mlab-modules/PCRD01/README.md

# PCRD01B
Semiconcductor cosmic radiation detector Silicon diode analogue amplifier. 

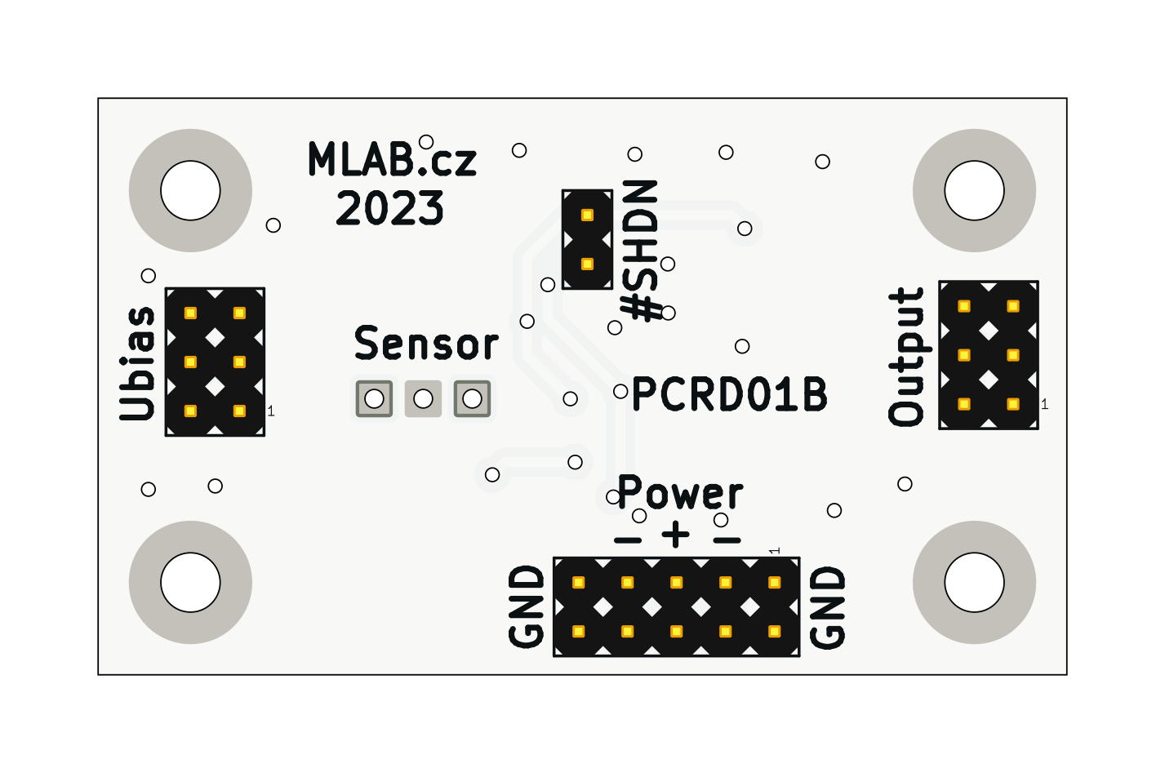
[picture p1: doc/gen/img/PCRD01-top.png]
PCRD01A
