mlab-modules/PCRD01/doc/gen/img/PCRD01-bottom.png

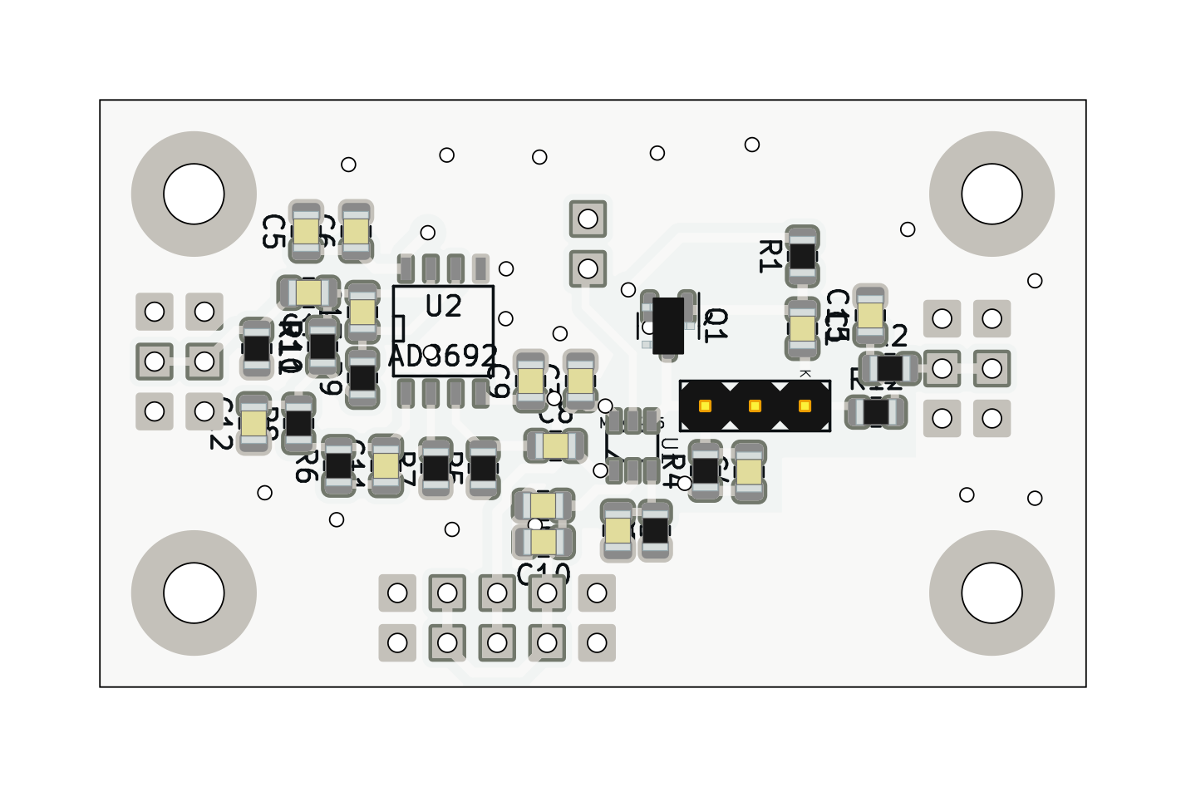
doc/gen/img/PCRD01-bottom.png
