mlab-modules/PCRD01/doc/gen/dxf/PCRD01-F_Cu.dxf

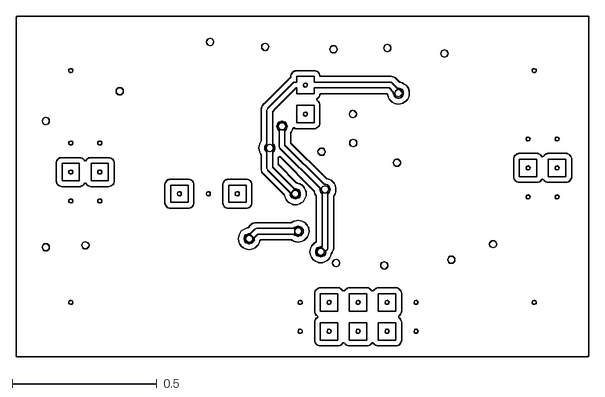
[picture p7: CAD file, 2023-07-05]
doc/gen/dxf/PCRD01-F_Cu.dxf
1.98 x 1.18
