mlab-modules/PCRD01/doc/gen/PCRD01.step

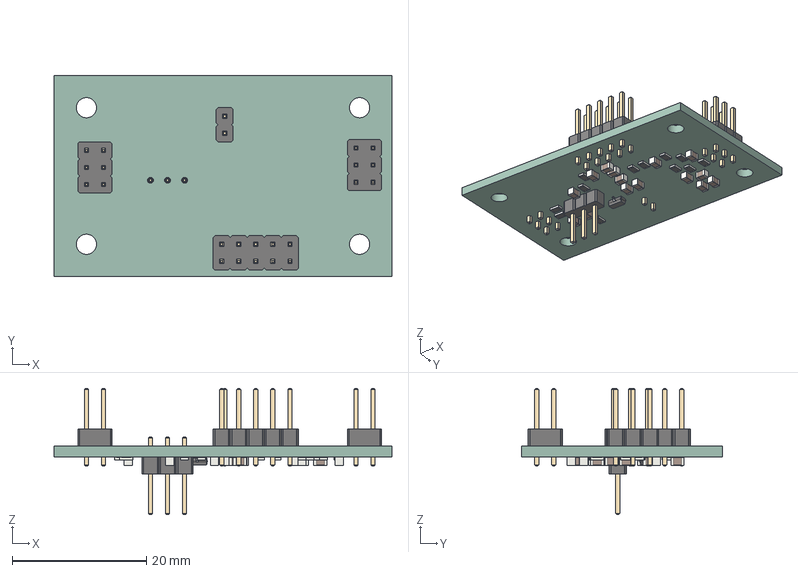
[picture p8: CAD file, 2023-07-05]
doc/gen/PCRD01.step
50.3 x 30.0 x 18.8 mm
tmp4__d5pkj PCB
