mlab-modules/PCRD01/doc/gen/dxf/PCRD01-User_Comments.dxf

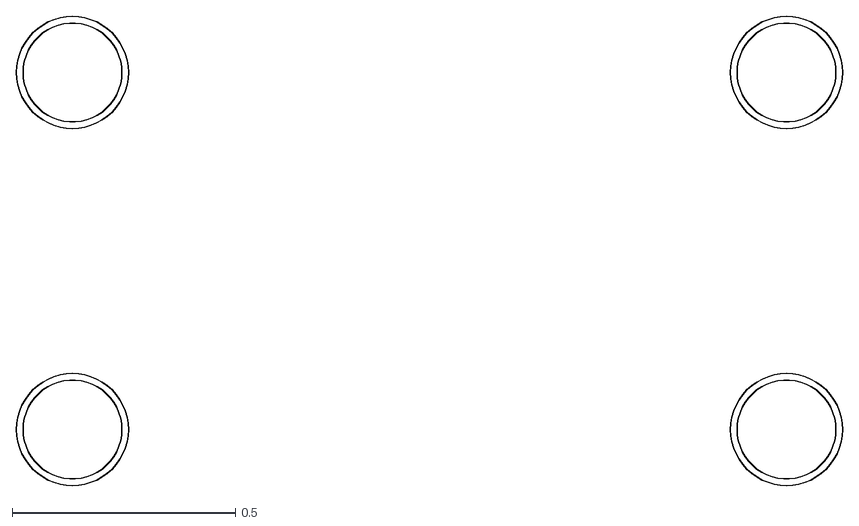
[picture p9: CAD file, 2023-07-05]
doc/gen/dxf/PCRD01-User_Comments.dxf
1.85 x 1.05
