mlab-modules/PCRD01/doc/gen/dxf/PCRD01-Edge_Cuts.dxf

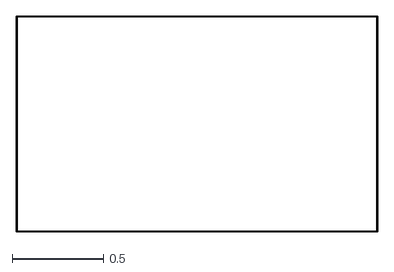
[picture p10: CAD file, 2023-07-05]
doc/gen/dxf/PCRD01-Edge_Cuts.dxf
1.98 x 1.18
