mlab-modules/PCRD01/doc/gen/dxf/PCRD01-B_Fab.dxf

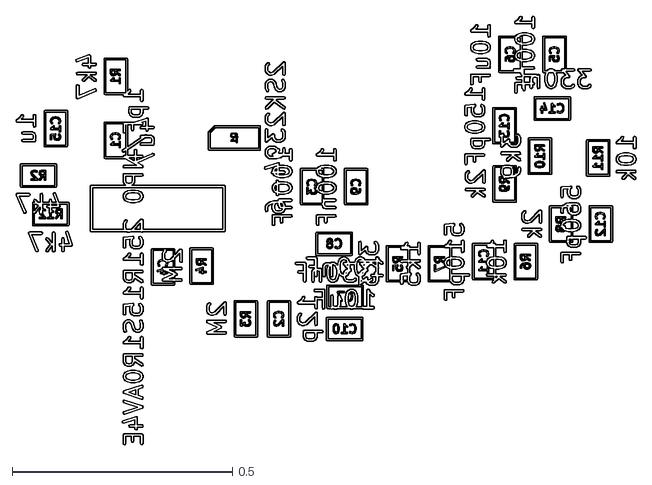
[picture p11: CAD file, 2023-07-05]
doc/gen/dxf/PCRD01-B_Fab.dxf
1.41 x 0.972
