mlab-modules/PCRD01/doc/gen/dxf/PCRD01-B_Cu.dxf

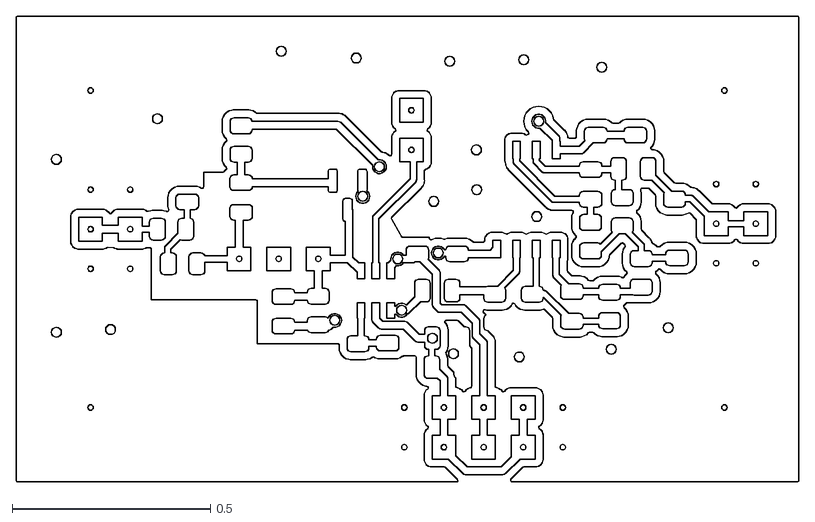
[picture p12: CAD file, 2023-07-05]
doc/gen/dxf/PCRD01-B_Cu.dxf
1.98 x 1.18
