mlab-modules/PCRD01/doc/gen/dxf/PCRD01-B_Courtyard.dxf

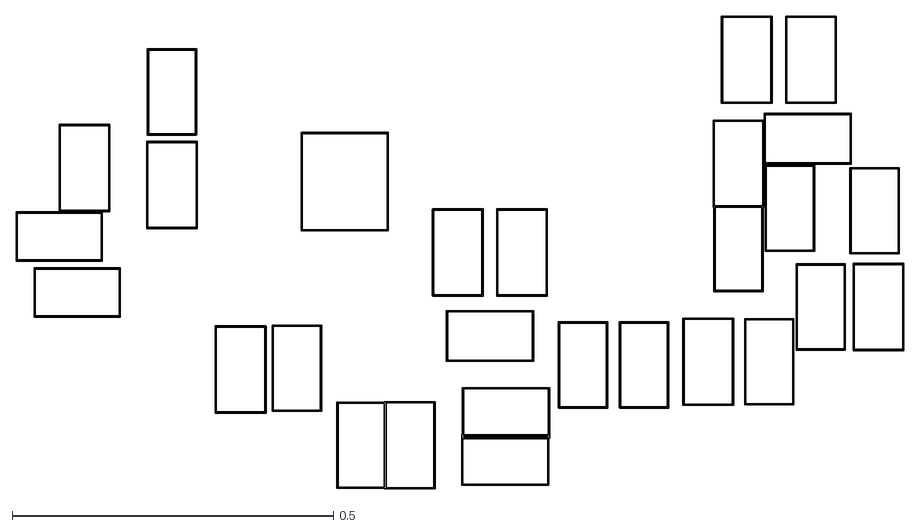
[picture p13: CAD file, 2023-07-05]
doc/gen/dxf/PCRD01-B_Courtyard.dxf
1.38 x 0.736
