mlab-modules/PCRD01/doc/gen/dxf/PCRD01-F_Fab.dxf

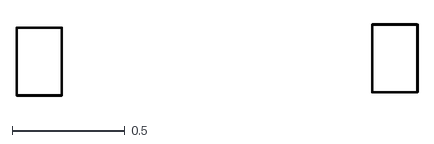
[picture p14: CAD file, 2023-07-05]
doc/gen/dxf/PCRD01-F_Fab.dxf
1.78 x 0.32
