mlab-modules/PCRD01/doc/gen/dxf/PCRD01-F_Adhesive.dxf

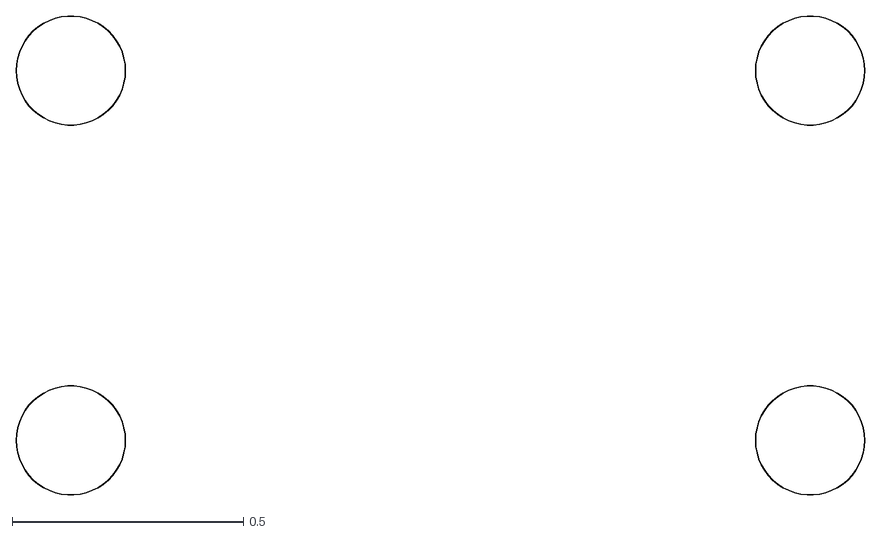
[picture p15: CAD file, 2023-07-05]
doc/gen/dxf/PCRD01-F_Adhesive.dxf
1.84 x 1.04
