mlab-modules/PCRD01/(list of files, cad)

Other CAD files:
doc/gen/dxf/PCRD01-User_Eco2.dxf
doc/gen/dxf/PCRD01-User_Drawings.dxf
doc/gen/dxf/PCRD01-F_Courtyard.dxf
doc/gen/dxf/PCRD01-Margin.dxf
doc/gen/dxf/PCRD01-User_Eco1.dxf
doc/gen/dxf/PCRD01-B_Mask.dxf
doc/gen/dxf/PCRD01-B_Paste.dxf
doc/gen/dxf/PCRD01-B_Silkscreen.dxf
doc/gen/dxf/PCRD01-F_Mask.dxf
doc/gen/dxf/PCRD01-F_Paste.dxf
doc/gen/dxf/PCRD01-F_Silkscreen.dxf
