mlab-modules/PCRD01/doc/gen/PCRD01-schematic.pdf

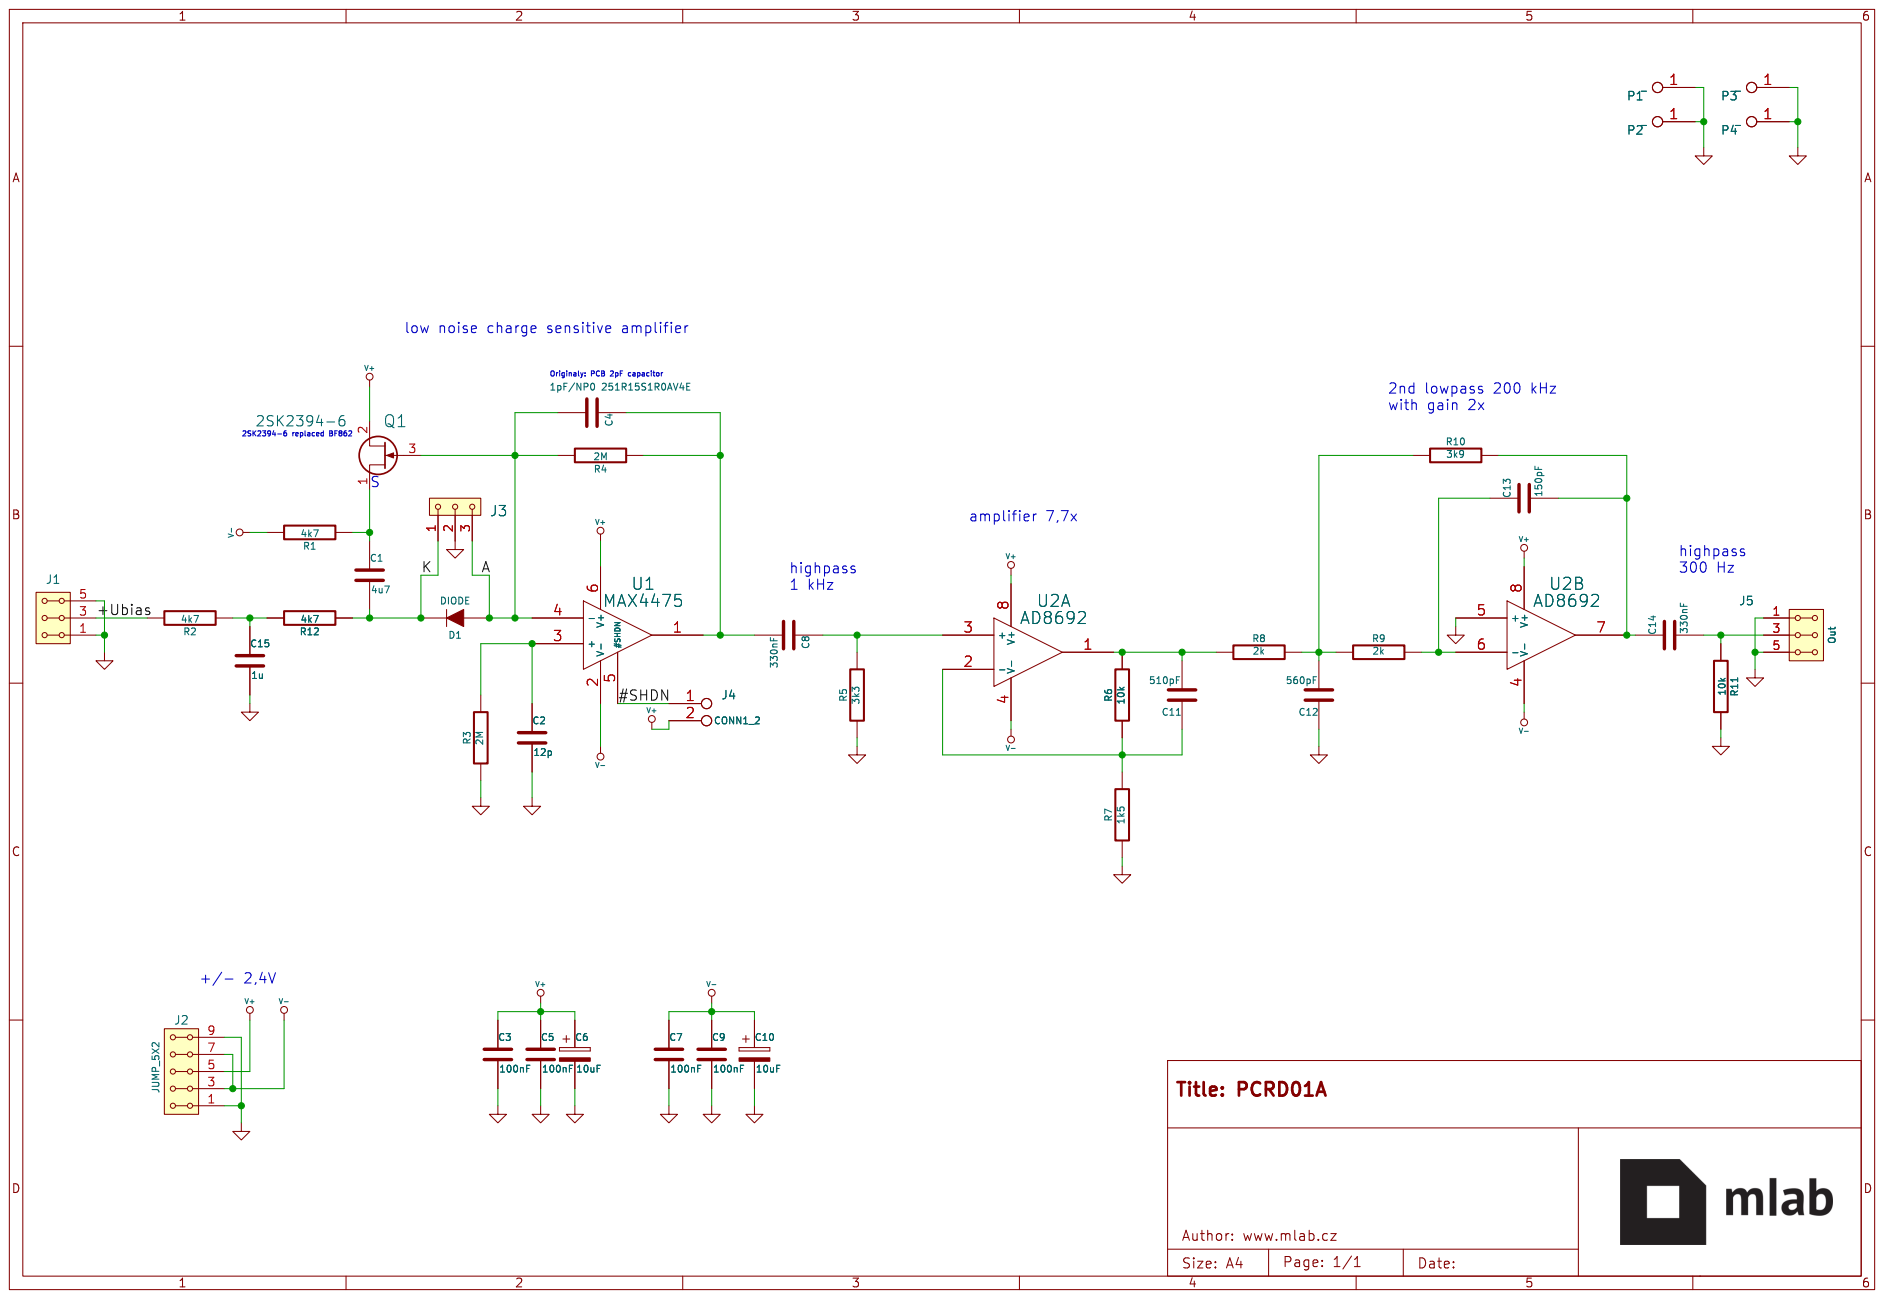
[picture p16: page 1]

low noise charge sensitive amplifier
