mlab-modules/PCRD01/hw/cam_profi/docs/PCRD01B-B_Fab+Edge_Cuts.pdf

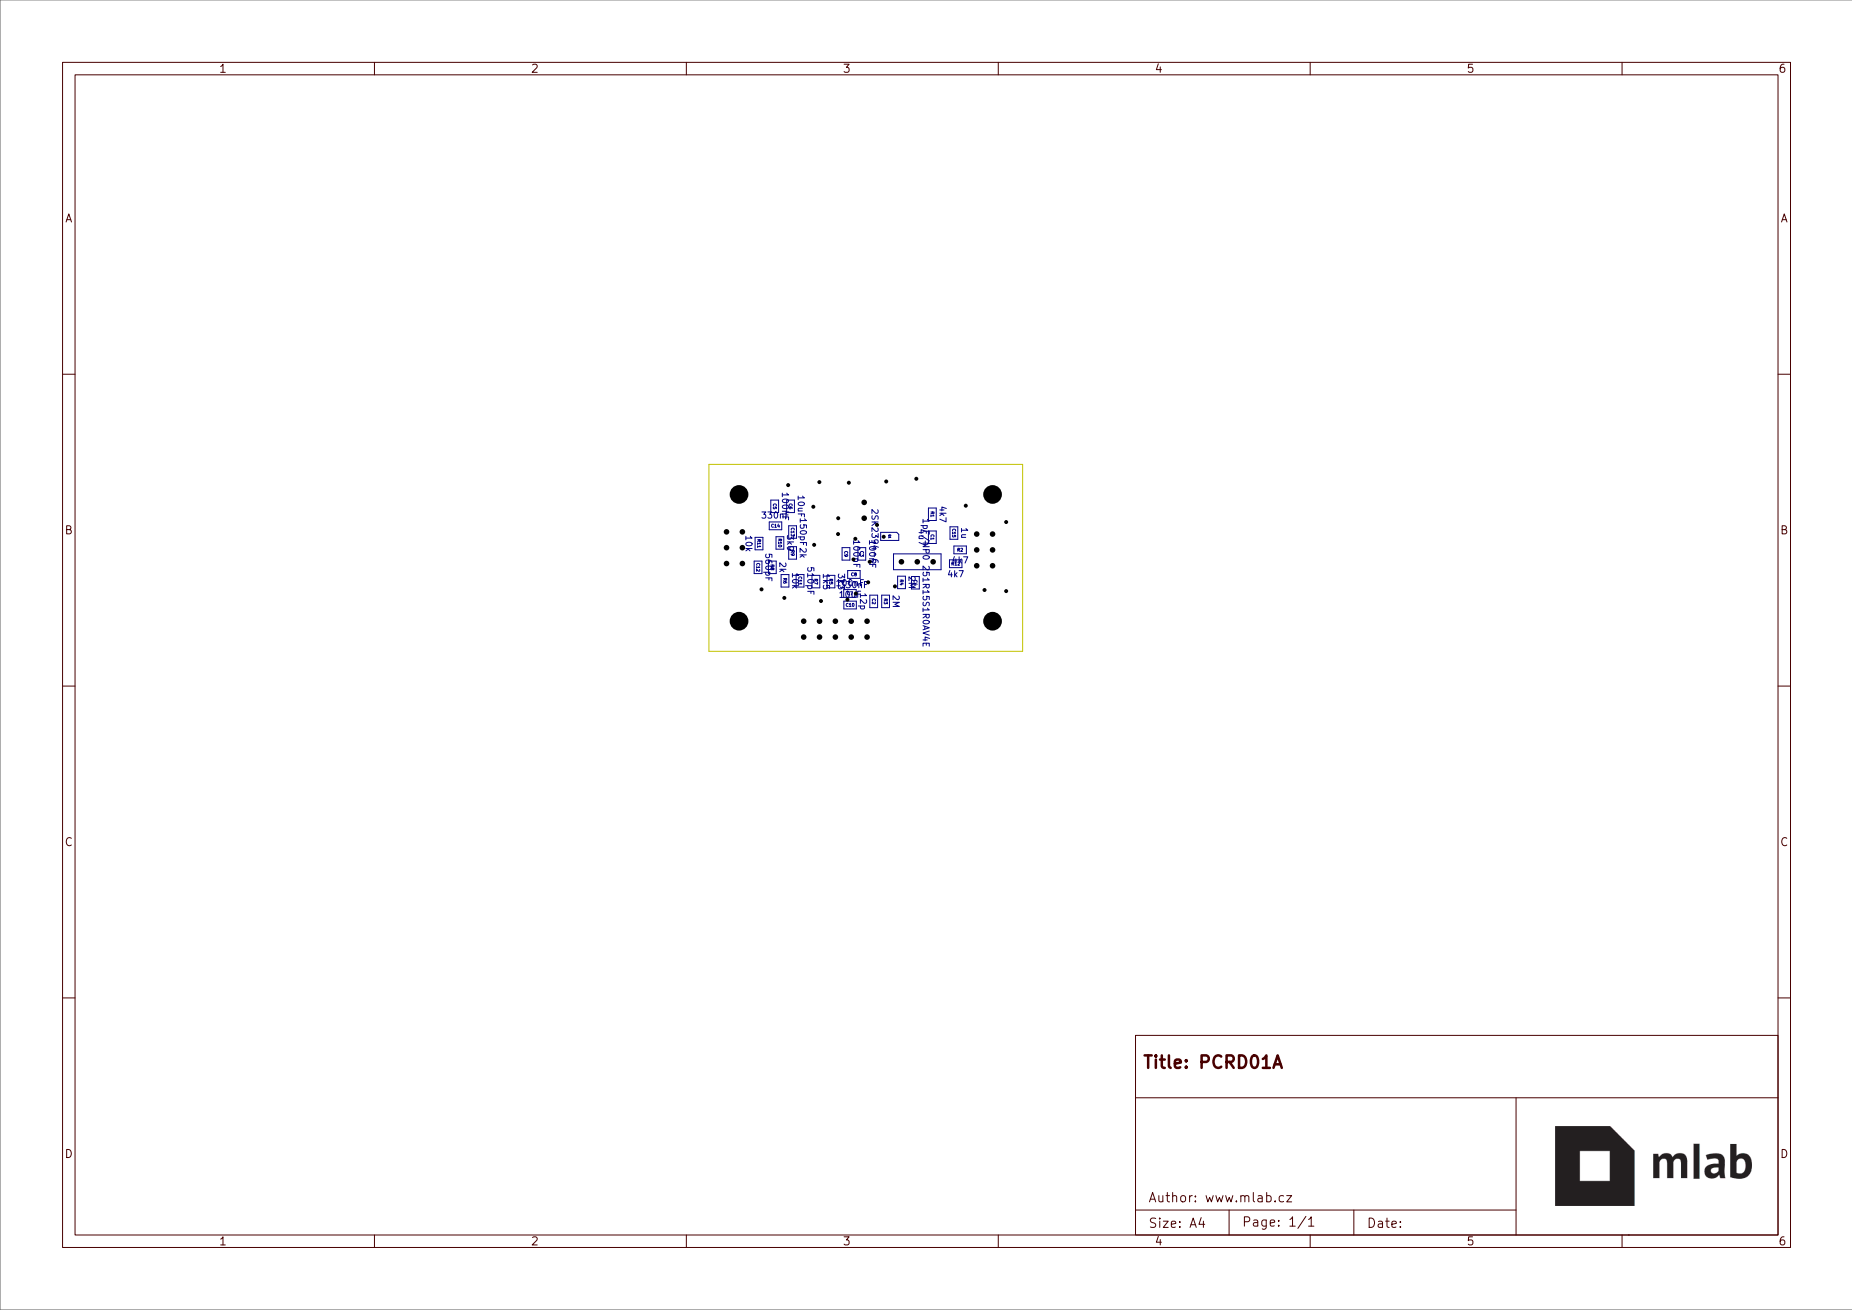
[picture p17: page 1]
