mlab-modules/PCRD01/hw/cam_profi/docs/PCRD01B-F_Fab+Edge_Cuts.pdf

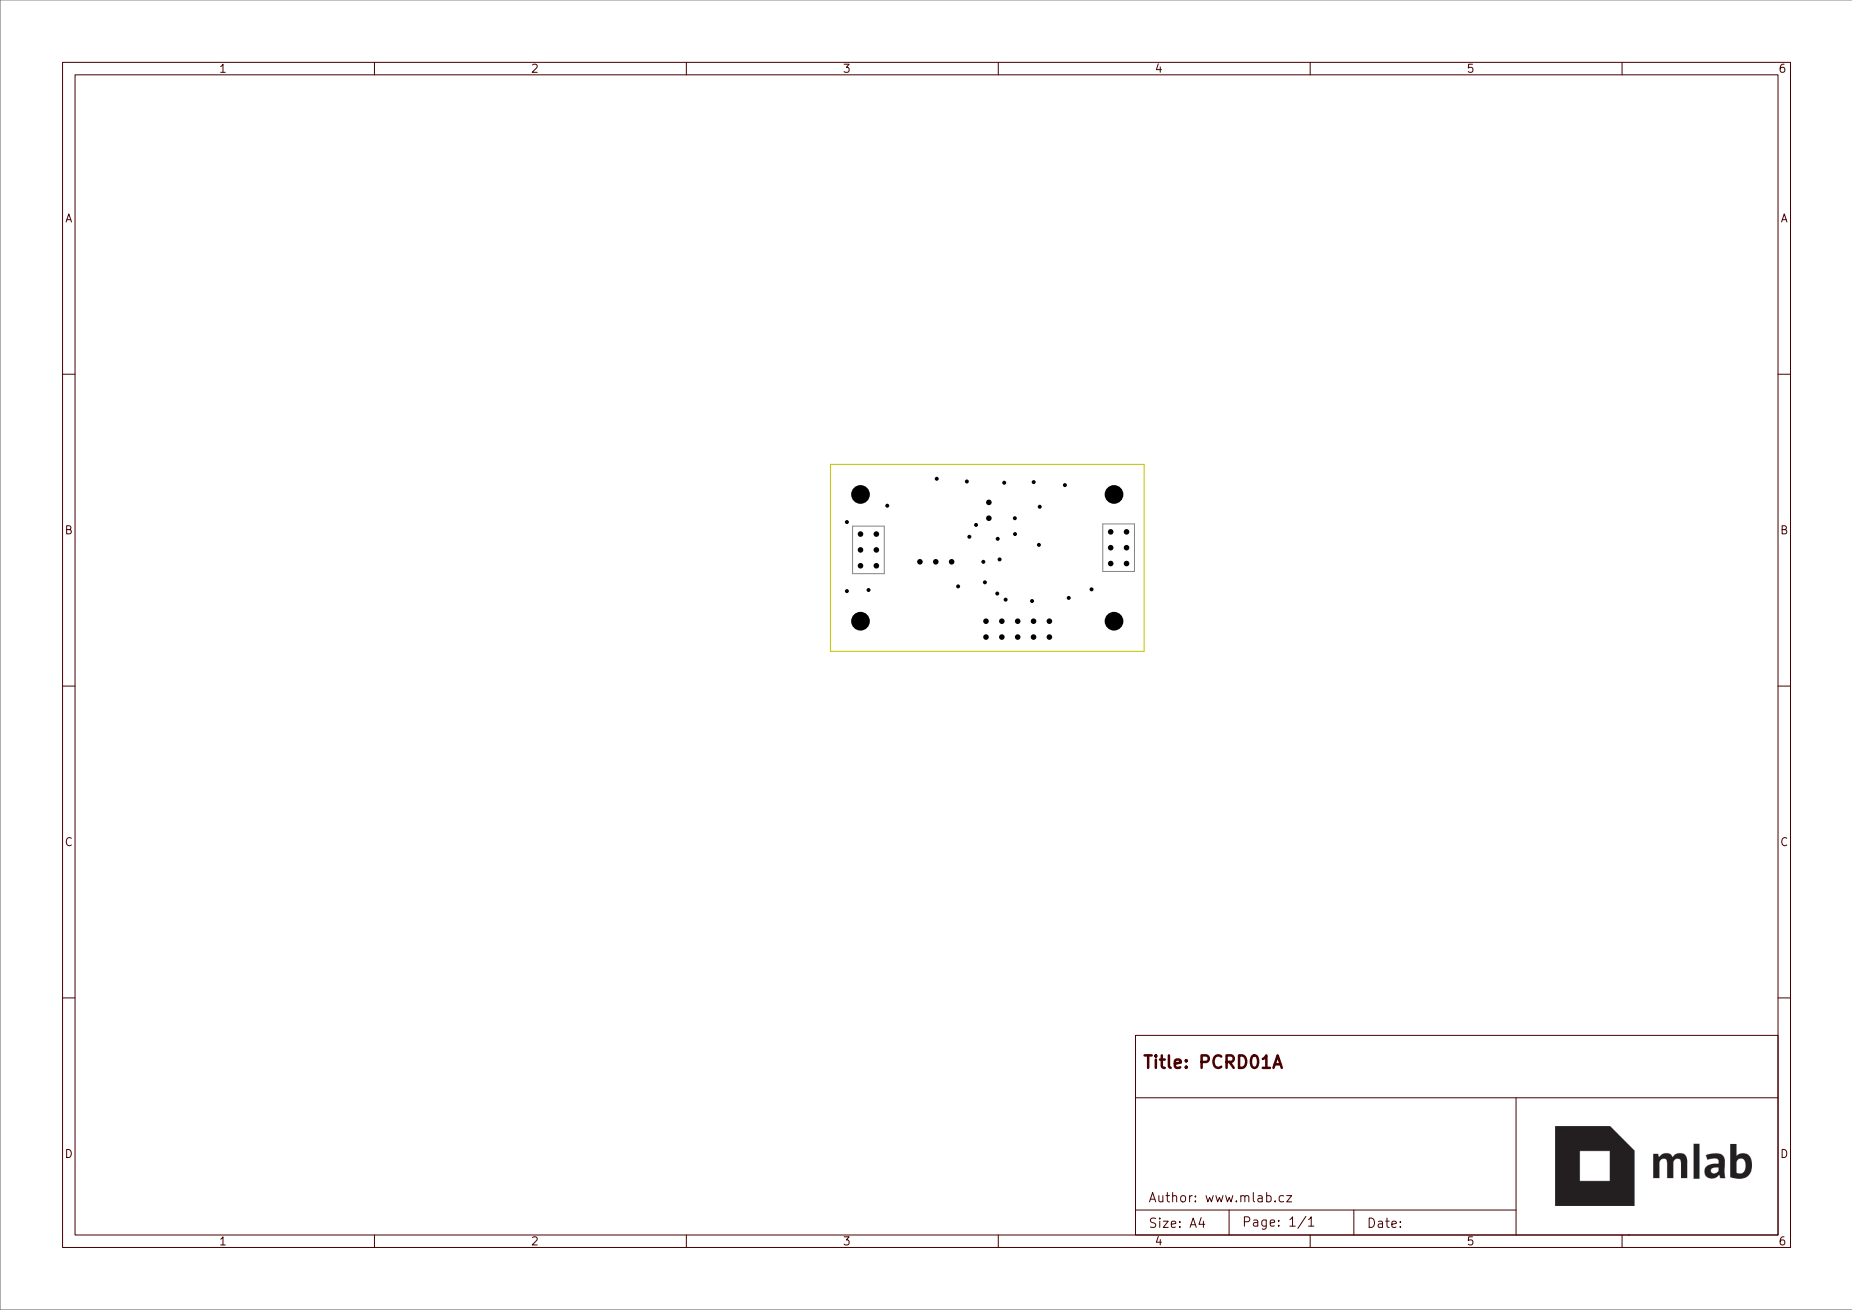
[picture p18: page 1]
