mlab-modules/PCRD01/hw/sch_pcb/PCRD01.kicad_pcb

## KiCad design hw/sch_pcb/PCRD01.kicad_pcb (2023-04-13)

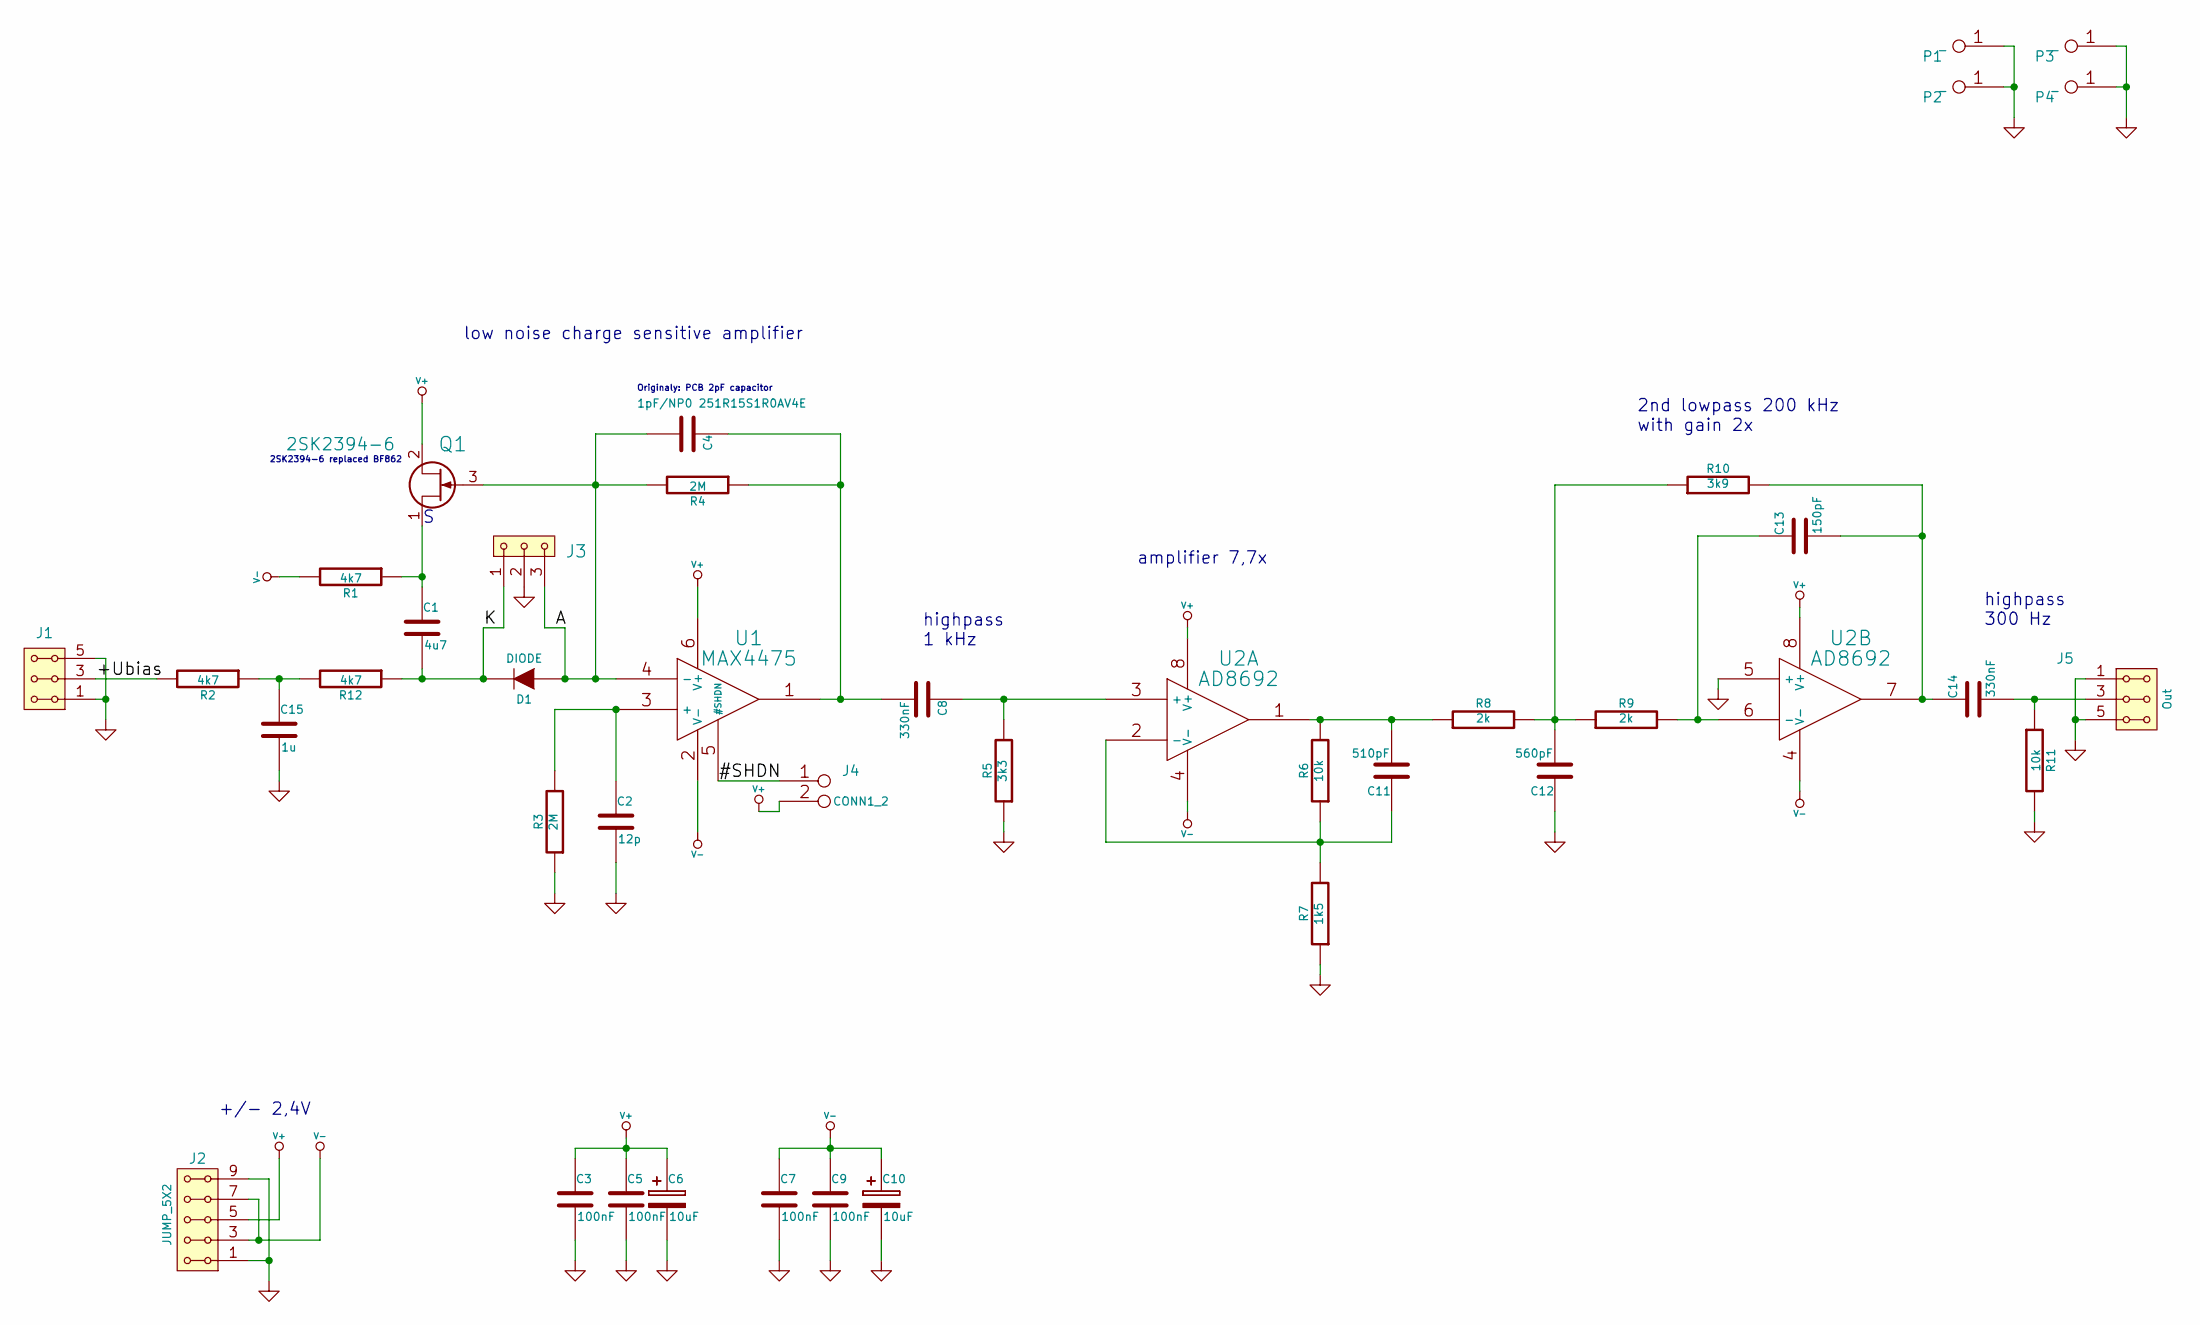
[picture p19: schematic PCRD01.kicad_sch, PCRD01A]

Parts:
C1: 4u7; C_0805_2012Metric
C2: 12p; C_0805_2012Metric
C3, C5, C7, C9: 100nF; C_0805_2012Metric
C4: 1pF/NP0 251R15S1R0AV4E; C_0805_2012Metric
C6, C10: 10uF; C_0805_2012Metric
C8, C14: 330nF; C_0805_2012Metric
C11: 510pF; C_0805_2012Metric
C12: 560pF; C_0805_2012Metric
C13: 150pF; C_0805_2012Metric
C15: 1u; C_0805_2012Metric
D1: DIODE
J1: JUMP_3X2; Straight_2x03
J2: JUMP_5X2; Straight_2x05
J3: HEADER_1x03; Straight_1x03
J4: CONN1_2; Straight_1x02
J5: Out; Straight_2x03
P1, P2, P3, P4: _; MountingHole_3mm
Q1: 2SK2394-6; SOT-23
R1, R2, R12: 4k7; R_0805_2012Metric
R3, R4: 2M; R_0805_2012Metric
R5: 3k3; R_0805_2012Metric
R6, R11: 10k; R_0805_2012Metric
R7: 1k5; R_0805_2012Metric
R8, R9: 2k; R_0805_2012Metric
R10: 3k9; R_0805_2012Metric
U1: MAX4475; SOT-23-6
U2: AD8692; SOIC-8-N

Connections:
/#SHDN: J4.1, U1.5 (#SHDN)
/+Ubias: J1.3, J1.4, R2.2
/A: C4.2, D1.1 (A), J3.3, Q1.3 (G), R4.2, U1.4 (-)
/K: C1.2, D1.2 (K), J3.1, R12.1
GND: C2.2, C3.2, C5.2, C6.2, C7.2, C9.2, C10.2, C12.1, C15.2, J1.1, J1.2, J1.5, J1.6, J2.1, J2.2, J2.9, J2.10, J3.2, J5.1, J5.2, J5.5, J5.6, P1.1, P2.1, P3.1, P4.1, R3.1, R5.1, R7.1, R11.2, U2.5 (+)
unnamed: C1.1, Q1.1 (S), R1.1
unnamed: C2.1, R3.2, U1.3 (+)
unnamed: C4.1, C8.2, R4.1, U1.1
unnamed: C8.1, R5.2, U2.3 (+)
unnamed: C11.1, R6.1, R7.2, U2.2 (-)
unnamed: C11.2, R6.2, R8.1, U2.1
unnamed: C12.2, R8.2, R9.1, R10.1
unnamed: C13.1, R9.2, U2.6 (-)
unnamed: C13.2, C14.1, R10.2, U2.7
unnamed: C14.2, J5.3, J5.4, R11.1
unnamed: C15.1, R2.1, R12.2
V+: C3.1, C5.1, C6.1, J2.5, J2.6, J4.2 (PM), Q1.2 (D), U1.6 (V+), U2.8 (V+)
V-: C7.1, C9.1, C10.1, J2.3, J2.4, J2.7, J2.8, R1.2, U1.2 (V-), U2.4 (V-)

Notes on the sheet:
highpass 300 Hz
2nd lowpass 200 kHz with gain 2x
+/- 2,4V
amplifier 7,7x
Originaly: PCB 2pF capacitor
2SK2394-6 replaced BF862
low noise charge sensitive amplifier
highpass 1 kHz

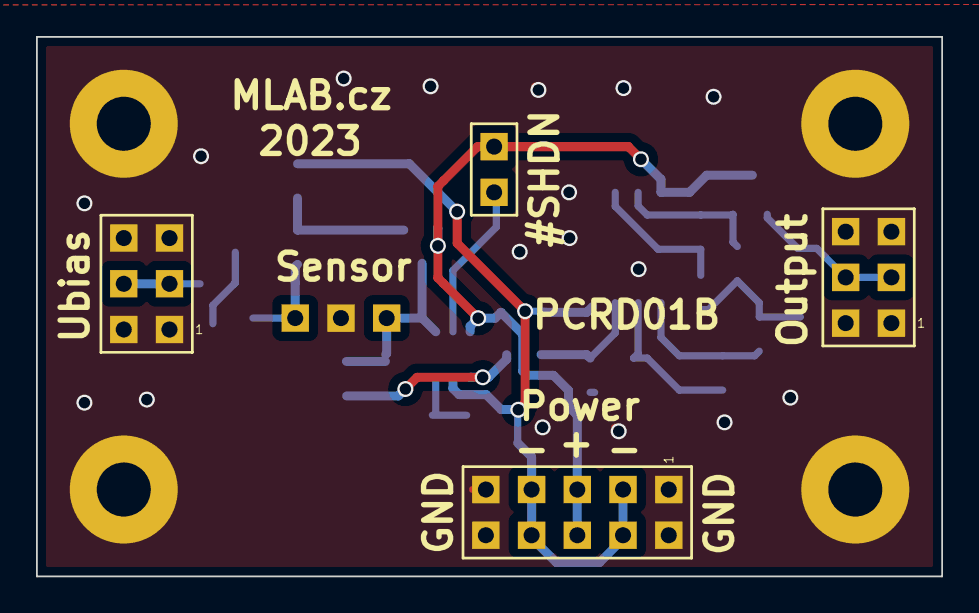
[picture p20: board PCRD01.kicad_pcb from above]

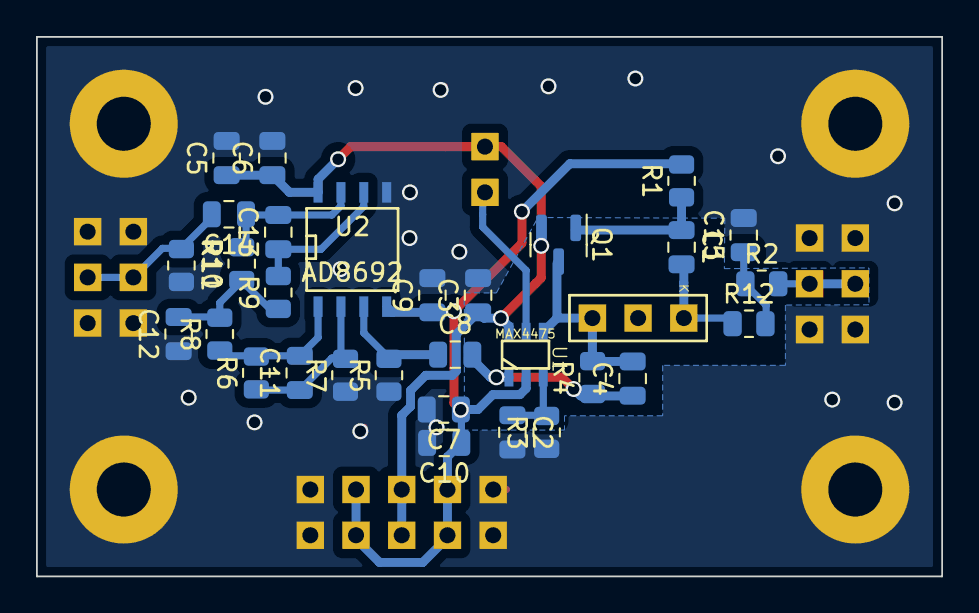
[picture p21: board PCRD01.kicad_pcb from below]

Board: 2 copper layers, 50.3 x 30.0 mm, 39 parts (31 on the bottom side), 18 nets.
