mlab-modules/PCRD01/(commit log)

2017-08-24 Microcontrollers and processors moved to separate directory.
    [PCRD01A.kicad_pcb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]
2022-04-06 Update actions products
    [PCRD01A-B_Cu.gbr, PCRD01A-B_Mask.gbr, PCRD01A-Edge_Cuts.gbr, PCRD01A-F_Cu.gbr, PCRD01A-F_Mask.gbr, PCRD01A-F_SilkS.gbr, PCRD01A.drl]
2023-04-12 convert to kicad 6
    [PCRD01.kicad_pcb, PCRD01.kicad_sch, PCRD01A.kicad_pcb, PCRD01A.sch]
2023-04-12 add sheet-stamp
    [PCRD01.kicad_pcb, PCRD01.kicad_sch]
2023-04-12 add ust identificators
    [PCRD01.kicad_pcb, PCRD01.kicad_sch]
2023-04-12 clean layout
    [PCRD01.kicad_pcb]
2023-04-12 rename id
    [PCRD01.kicad_sch]
2023-04-12 replace PCB capacitor
    [PCRD01.kicad_pcb, PCRD01.kicad_sch]
2023-04-12 uklid layoutu
    [PCRD01.kicad_pcb, PCRD01.kicad_sch]
2023-04-12 rename to 01B
    [PCRD01.kicad_pcb]
2023-04-13 Edit PCB
    [PCRD01.kicad_pcb, PCRD01.kicad_sch]
2023-04-13 Fix #2 Add dimensions.
    [PCRD01.kicad_pcb]
2023-04-13 Disable visibility of irrelevant text.
    [PCRD01.kicad_pcb]
